ep4hr/TRX-controller/image png/image1.png

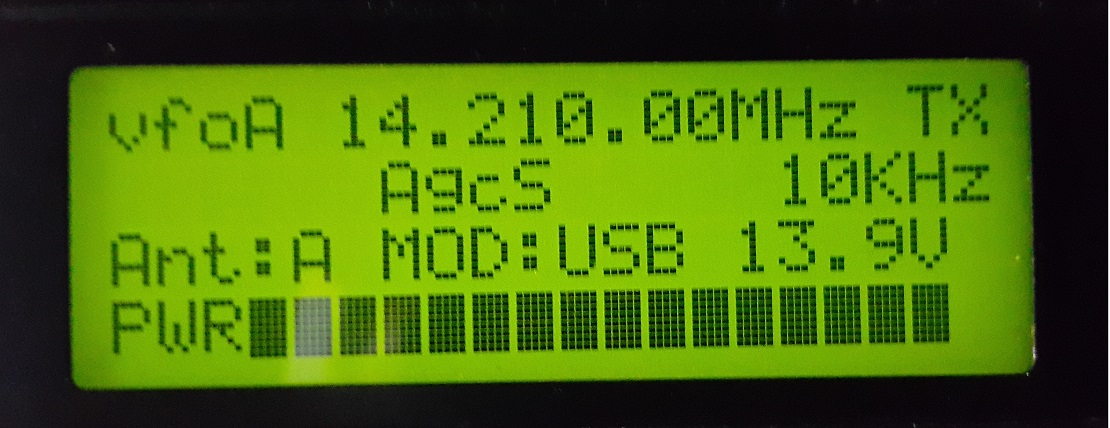
image png/image1.png
