ep4hr/TRX-controller/image png/image4.png

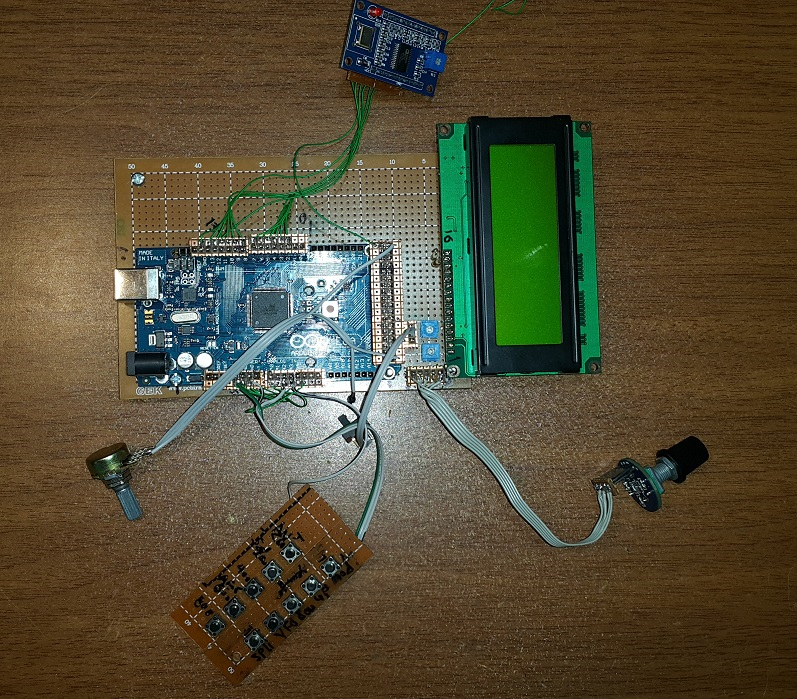
image png/image4.png
