ep4hr/TRX-controller/image png/image2.png

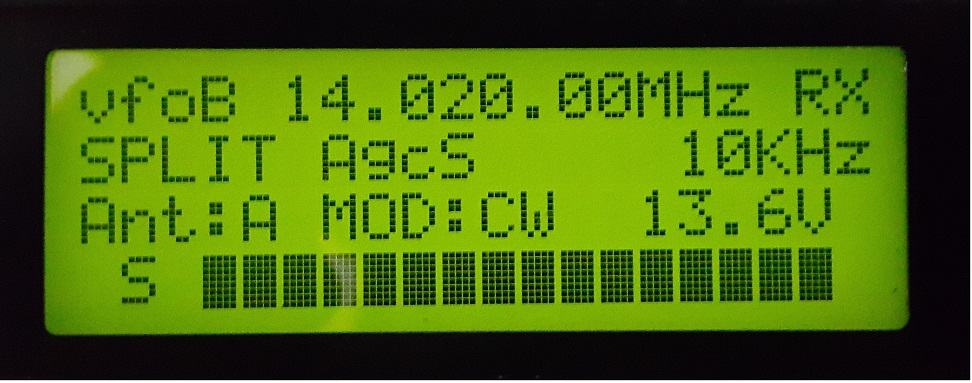
image png/image2.png
