ep4hr/TRX-controller/image png/image3.png

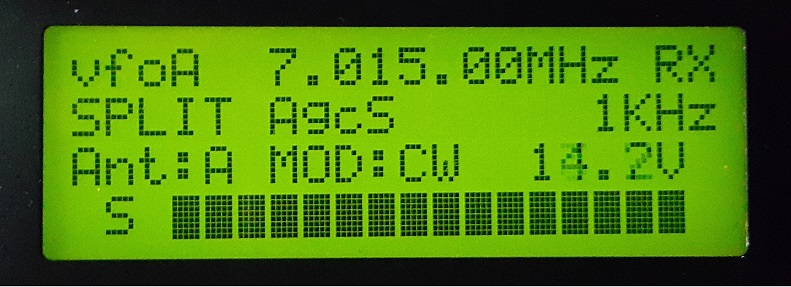
image png/image3.png
