ep4hr/TRX-controller/TRX control.jpg

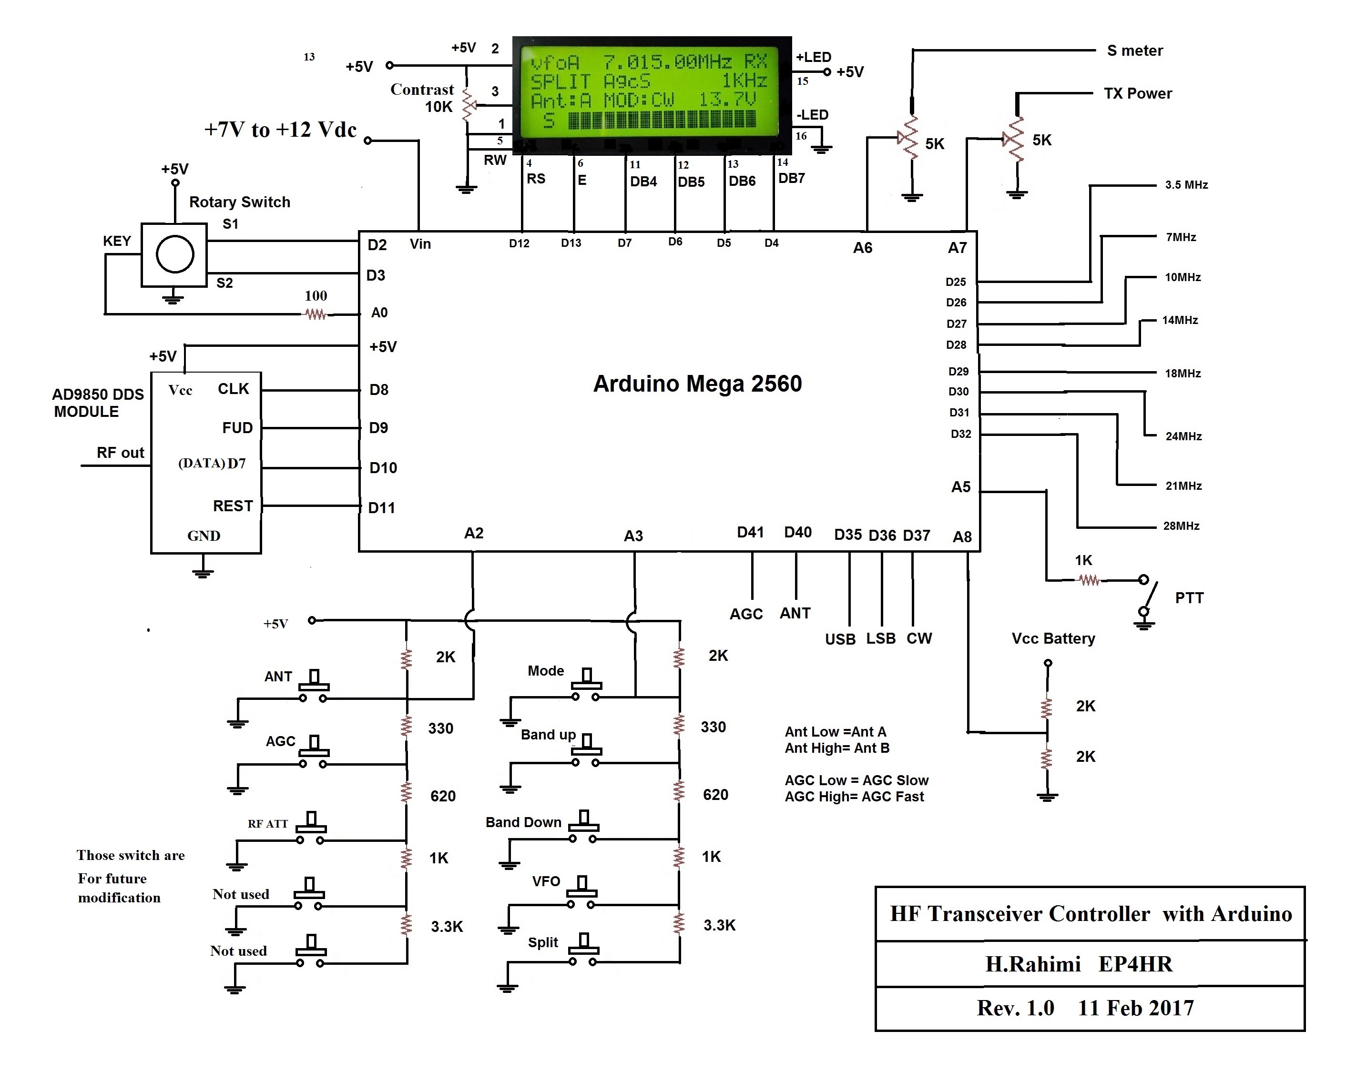
TRX control.jpg
