ep4hr/TRX-controller/(commit log)

2017-02-11 HF ham band transceiver controller By H.Rahimi EP4HR ( ep4hr@yahoo.com) This Project is a controller for HF ham band transceiver .Main parts of project is Arduino Mega 2560 and AD9850 DDS module . I 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
2017-02-11 HF Ham Band Transceiver controller
    This Project is a HF Ham Band Transceiver By Arduino mega and AD9850 DDS and LCD 20x4
